SbRhubarbPie/PieBoard/(commit log)

2025-06-20 Add files via upload
    update to include neopixel decoupling caps
    [PieBoard.kicad_sch]
2025-06-20 Update BOM.csv
    add 10uf decoupling caps
    [BOM.csv]
2025-06-21 Update BOM.csv
    keyswitches out of stock from previous seller
    [BOM.csv]
2025-06-21 Update BOM.csv
    new final price with new keyswtich source
    [BOM.csv]
